LoriAzniveBerberian/PARcast/prototyping/E_dzPAR_schematic.pptx

PARcast: E_d(z, PAR) breadboard wiring

In-water profiler: top-down view on a prototyping breadboard

+

–

a

5

ADS1115

16-bit ADC

10

15

DS3231

Real-time clock

20

25

MS5837

Pressure (0x76)

30

35

Teensy 4.1

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
Built-in
microSD slot

USB on right end

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
ADDR

ALRT

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
19 (SCL0)

18 (SDA0)

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
Apogee SQ-500

PAR sensor (0–40 mV, self-powered)

Serial 1559+: White / Black / Clear (grey)

Wire legend

Red — 3.3 V

Notes

• I2C bus shared by ADS1115, DS3231, MS5837

Black — GND

Yellow — SCL (I2C clock)

• Addresses: 0x48, 0x68, 0x76

• Teensy SDA0 = pin 18, SCL0 = pin 19

White → A0

Black → A1

Clear (grey) → GND (shield)

Blue — SDA (I2C data)

White — SQ-500 signal +

Gray dashed — SQ-500 shield

• SQ-500 differential: reads A0 − A1

• SQ-500 self-powered, no Vcc

• Underwater: apply 1.25× immersion factor

• MS5837 sealed via 1.8×0.8 mm O-ring

## Slide 2

E_d(z, PAR) connection table

Authoritative pin-by-pin reference for build

From | Pin / wire | To | Pin / wire | Wire color | Purpose
Teensy 4.1 | 3V3 | Breadboard | Top + rail | Red | Main 3.3 V distribution
Teensy 4.1 | GND | Breadboard | Top – rail | Black | Main ground distribution
Top + rail | — | ADS1115 | VDD | Red | ADC power
Top – rail | — | ADS1115 | GND | Black | ADC ground
Top + rail | — | DS3231 | Vin | Red | RTC power
Top – rail | — | DS3231 | GND | Black | RTC ground
Top + rail | — | MS5837 | VDD | Red | Pressure sensor power
Top – rail | — | MS5837 | GND | Black | Pressure sensor ground
Teensy 4.1 | Pin 18 (SDA0) | ADS1115 | SDA | Blue | I2C data
Teensy 4.1 | Pin 18 (SDA0) | DS3231 | SDA | Blue | I2C data (shared bus)
Teensy 4.1 | Pin 18 (SDA0) | MS5837 | SDA | Blue | I2C data (shared bus)
Teensy 4.1 | Pin 19 (SCL0) | ADS1115 | SCL | Yellow | I2C clock
Teensy 4.1 | Pin 19 (SCL0) | DS3231 | SCL | Yellow | I2C clock (shared bus)
Teensy 4.1 | Pin 19 (SCL0) | MS5837 | SCL | Yellow | I2C clock (shared bus)
SQ-500 | White wire | ADS1115 | A0 | White | Sensor signal positive
SQ-500 | Black wire | ADS1115 | A1 | Black | Sensor signal negative
SQ-500 | Clear shield | Bottom – rail | — | Gray (dashed) | Shield to ground
