LoriAzniveBerberian/PARcast/prototyping/E_sPAR_schematic.pptx

PARcast: E_s(PAR) breadboard wiring

Land station reference sensor: top-down view on a prototyping breadboard

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
ADS1115

16-bit ADC

DS3231

Real-time clock

Teensy 4.1

Built-in microSD slot

USB
on right end

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
ADDR

ALRT

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
18 (SDA0)

19 (SCL0)

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
Apogee SQ-500

PAR sensor (0–40 mV, self-powered)

Serial 1559+: White / Black / Clear (grey)

White → A0

Black → A1

Wire legend

Black — GND

Notes

Red — 3.3 V

• I2C bus shared by ADS1115 and DS3231

• ADS1115 address 0x48, DS3231 address 0x68

Clear (grey) → GND (shield)

Yellow — SCL (I2C clock)

Blue — SDA (I2C data)

White — SQ-500 signal +

• Teensy SDA0 = pin 18, SCL0 = pin 19

• SQ-500 differential: reads A0 − A1

• SQ-500 is self-powered, no Vcc

Gray dashed — SQ-500 shield

• microSD lives in Teensy built-in slot

PARcast — github.com/LoriAzniveBerberian/PARcast

## Slide 2

E_d(PAR) connection table

Authoritative pin-by-pin reference for build

From | Pin / wire | To | Pin / wire | Wire color | Purpose
Teensy 4.1 | 3V3 | Breadboard | Top + rail | Red | Main 3.3 V distribution
Teensy 4.1 | GND | Breadboard | Top – rail | Black | Main ground distribution
Top + rail | — | ADS1115 | VDD | Red | ADC power
Top – rail | — | ADS1115 | GND | Black | ADC ground
Top + rail | — | DS3231 | Vin | Red | RTC power
Top – rail | — | DS3231 | GND | Black | RTC ground
Teensy 4.1 | Pin 18 (SDA0) | ADS1115 | SDA | Blue | I2C data
Teensy 4.1 | Pin 18 (SDA0) | DS3231 | SDA | Blue | I2C data (shared bus)
Teensy 4.1 | Pin 19 (SCL0) | ADS1115 | SCL | Yellow | I2C clock
Teensy 4.1 | Pin 19 (SCL0) | DS3231 | SCL | Yellow | I2C clock (shared bus)
SQ-500 | White wire | ADS1115 | A0 | White | Sensor signal positive
SQ-500 | Black wire | ADS1115 | A1 | Black | Sensor signal negative
SQ-500 | Clear shield | Bottom – rail | — | Gray (dashed) | Shield to ground
