LoriAzniveBerberian/PARcast/literature/instrument_design/IMG_1776.png

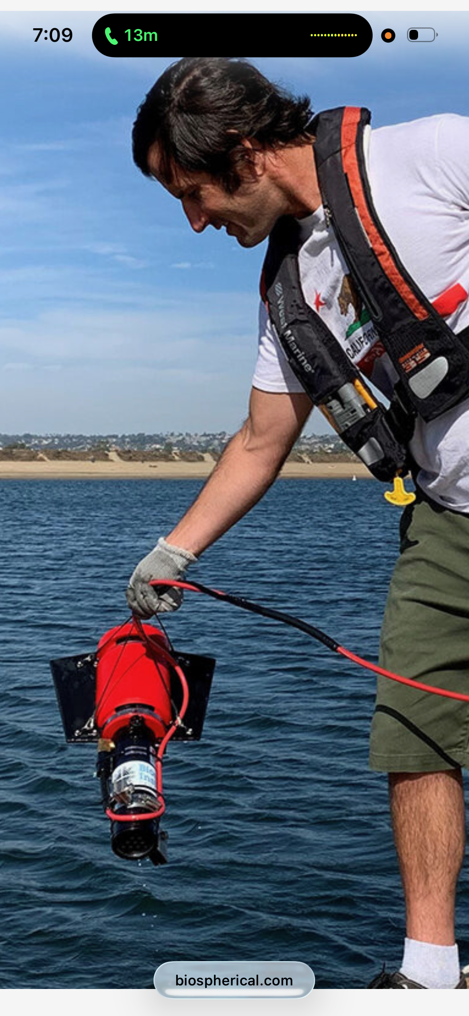
literature/instrument_design/IMG_1776.png
