LoriAzniveBerberian/PARcast/BOM/PARCAST_BOM.xlsx

Sheet: Ed profiler
PARCAST: E_d(z) in-water profiler, Bill of Materials
Item | Part | Qty | Part number | Size (mm) | Purchase link | Unit price (USD) | Line total (USD)
1. Pressure housing
1.1 | Locking tube, cast acrylic, 100 m | 1 | BR-101052-300 | 114.3 OD x 101.6 ID x 300 | https://bluerobotics.com/store/watertight-enclosures/locking-series/wte-locking-tube-r1-vp/ | $230.00 | $230.00
1.2 | O-ring sealing flange, 4 in | 2 | BR-101040 | 114.3 dia x 27 (19.1 inside tube) | https://bluerobotics.com/store/watertight-enclosures/locking-series/wte-flange-vp/ | $50.00 | $100.00
1.3 | End cap, aluminium, 5 x M10, 1000 m | 1 | WTE4-M-END-CAP-5-HOLE | 10 thick; 120.3 dia (CAD) | https://bluerobotics.com/store/watertight-enclosures/locking-series/wte-end-cap-vp/ | $36.00 | $36.00
1.4 | End cap, dome, optically clear polycarbonate, 500 m | 1 |  | 120.3 dia x 12.7 (CAD) | https://bluerobotics.com/store/watertight-enclosures/locking-series/wte-end-cap-vp/ | $42.00 | $42.00
1.5 | Heat shrink sleeve, 120 mm dia | 1 |  | 120 dia (191 flat width) x 1000 |  | $15.09 | $15.09
2. Cap hardware (5 x M10 ports, 56.0 mm bolt circle, 72 deg apart)
2.1 | Pressure relief valve, M10 | 1 | PRV-M10 | M10 thread; 18 dia x 49.5 (CAD) | https://bluerobotics.com/store/watertight-enclosures/enclosure-tools-supplies/prv-m10-asm/ | $32.00 | $32.00
2.2 | Depth / pressure sensor, Bar30, 0-30 bar | 1 | BR-100586 | M10 x 1.5 thread; 16 dia x 32 (CAD) | https://bluerobotics.com/product-category/sensors-cameras/sensors/ | $90.00 | $90.00
2.3 | WetLink penetrator, JPT M10, 4.5 mm HC, 3.7-4.3 mm cable | 3 | BR-107163-145 | M10 bulkhead, 3.7-4.3 cable; 16 A/F x 49 (CAD) | https://bluerobotics.com/store/cables-connectors/penetrators/wetlink-penetrator-jpt/ | $13.00 | $39.00
3. Internal structure
3.1 | Rail, 300 W | 2 | BR-102784-301 | 20 x 7.09 x 231 (CAD) | https://bluerobotics.com/store/watertight-enclosures/locking-series/watertight-enclosure-rails/
3.2 | Rectangular tray, 4 in | 3 | BR-103291-400 | 87 x 68 x 6 (CAD) | https://bluerobotics.com/store/watertight-enclosures/locking-series/watertight-enclosure-rails/ | $24.00 | $72.00
3.3 | Tray accessory mounting screws | 1 |  | M3 x 0.5 | https://bluerobotics.com/product-category/watertight-enclosures/locking-series/ | $3.00 | $3.00
4. Electronics
4.1 | Breadboard, 830-point solderless | 1 | ELEGOO 830-point | 830 tie-points; not listed by vendor |  | $3.00 | $3.00
4.2 | Breadboard, 830-point solderless | 1 | ELEGOO 830-point | 830 tie-points; not listed by vendor |  | $3.00 | $3.00
4.3 | Teensy 4.1 microcontroller | 1 | Adafruit 4622 (PJRC Teensy 4.1) | 61 x 18 (2.4 x 0.7 in) | https://www.adafruit.com/product/4622 | $29.95 | $29.95
4.4 | ADS1115 16-bit I2C ADC module | 1 | Qoroos ADS1115 (3-pack) | not listed by vendor | https://www.amazon.com/dp/B0F1D3KGG2 | $4.29 | $4.29
4.5 | DS3231 precision RTC | 1 | Adafruit 3013 | 23 x 17.6 x 7.2 | https://www.adafruit.com/product/3013 | $17.50 | $17.50
4.6 | LSM6DSOX + LIS3MDL 9-DoF IMU | 1 | Adafruit 4517 | 25.4 x 17.8 x 4.7 (CAD) | https://www.adafruit.com/product/4517 | $19.95 | $19.95
4.7 | Screw terminal, 3-way | 1 |  | 15 x 12 x 10 (CAD placeholder)
4.8 | microSD card, 128 GB, Gigastone | 1 |  | microSD standard, 15 x 11 x 1.0 |  | $24.49 | $24.49
4.9 | CR1220 coin cell (RTC backup) | 1 |  | 12 dia x 2.0
4.10 | Male header strips, female headers, F/F jumper wires | 1 | Adafruit 392, Adafruit 3141, HiLetgo 1x40 | 2.54 pitch; jumpers 150 long | https://www.adafruit.com/product/392 | $13.89 | $13.89
4.11 | USB-C to micro-USB cable, 6 in | 1 |  | 152 length (6 in) | https://www.amazon.com/dp/B0CMLS2MB1 | $12.16 | $12.16
4.12 | V25 USB battery pack | 1 | Voltaic V25 | 80 x 82 x 24 | https://voltaicsystems.com/v25/ | $45.00 | $45.00
4.13 | Hookup wire, 22 AWG solid core (6 colours x 30 ft) | 1 |  | 22 AWG; 6 x 9.1 m (30 ft) |  | $15.89 | $15.89
5. External mounting
5.1 | Enclosure cradle half | 2 | BR-102678-004 | 144.9 x 62.8 x 30 (CAD) | https://bluerobotics.com/store/rov/bluerov2-components-spares/brov2-asm-cradle-set-r1-rp/
5.2 | Tether cleat, aluminium | 2 | custom | 72 x 55 x 6, 13 dia M12 bore (CAD)
5.3 | M12 tether hardware (bolt, nuts, washers) | 1 |  | M12 x 1.75
6. Optical sensor
6.1 | Apogee SQ-500-SS quantum sensor | 1 | SQ-500-SS | 30.5 dia x 36.6 | https://www.apogeeinstruments.com/sq-500-ss-full-spectrum-quantum-sensor/ | $416.12 | $416.12
6.2 | Z-bracket riser | 1 | custom, 3D printed | 58.5 x 30.5 x 44.5 (CAD)
7. Deployment
7.1 | Ballast discs, stainless, 1/4 in | 10 |  | 76.2 dia x 6.35 (3 x 1/4 in) |  | $8.99 | $89.95
7.2 | Trim ballast discs, stainless, 2 mm (5-pack) | 1 |  | 76.2 dia x 2 (3 in) |  | $15.75 | $15.75
7.3 | Trim ballast discs, stainless, 1 mm (5-pack) | 1 |  | 76.2 dia x 1 (3 in) |  | $11.01 | $11.01
7.4 | Trim ballast discs, stainless, 0.5 mm (5-pack) | 1 |  | 76.2 dia x 0.5 (3 in) |  | $8.23 | $8.23
7.5 | Closed-cell foam, Minicell, black | 1 |  | 610 x 305 x 114 (24 x 12 x 4.5 in) |  | $38.85 | $38.85
8. Optional deployment accessories (choose per application; not included in TOTAL)
8.1 | Float line, 100 ft, 550 lb (MIMIRACLE) | 1 |  | 30.5 m (100 ft), 550 lb test |  | $99.99 | $99.99
8.2 | Float line, 50 ft, 550 lb (MIMIRACLE) | 1 |  | 15.2 m (50 ft), 550 lb test |  | $69.99 | $69.99
8.3 | Picasso Hydro Float | 2 |  | not listed by vendor | https://www.spearamerica.com/products/picasso-hydro-float | $58.95 | $117.90
8.4 | SpearPro 316 marine stainless bow shackle | 1 |  | 5/32 in | https://www.spearamerica.com/products/316-marine-stainless-bow-shackle | $5.95 | $5.95
8.5 | SpearPro tuna clip with swivel | 2 |  | not listed by vendor | https://www.spearamerica.com/products/tuna-clip-with-swivel | $5.95 | $11.90
8.6 | SpearPro pigtail swivel, 600 lb | 1 |  | 600 lb rated | https://www.spearamerica.com/products/spearpro-pigtail-swivel-600lb | $4.95 | $4.95
 | TOTAL |  |  |  |  |  | $1428.12
 | Optional accessories (not in TOTAL) |  |  |  |  |  | $310.68

Sheet: Es surface reference
PARCAST: E_s(PAR) surface reference, Bill of Materials
Item | Part | Qty | Part number | Size (mm) | Purchase link | Unit price (USD) | Line total (USD)
1. Enclosure
1.1 | Weatherproof project box, QILIPSU IP67 ABS | 1 |  | 175 x 124 x 99 (6.9 x 4.9 x 3.9 in) |  | $15.99 | $15.99
1.2 | Cable gland, 1/4 in NPT, IP68 nylon | 2 |  | 1/4 in NPT |  | $0.75 | $1.50
2. Optical sensor
2.1 | Apogee SQ-500-SS quantum sensor | 1 | SQ-500-SS | 30.5 dia x 36.6 | https://www.apogeeinstruments.com/sq-500-ss-full-spectrum-quantum-sensor/ | $416.12 | $416.12
2.2 | Apogee AL-100 solar sensor leveling plate | 1 | AL-100 | not listed by vendor | https://www.apogeeinstruments.com/al-100-solar-sensor-leveling-plate/ | $61.79 | $61.79
3. Electronics
3.1 | Breadboard, 830-point solderless | 1 | ELEGOO 830-point | 830 tie-points; not listed by vendor |  | $3.00 | $3.00
3.2 | Teensy 4.1 microcontroller | 1 | Adafruit 4622 (PJRC Teensy 4.1) | 61 x 18 (2.4 x 0.7 in) | https://www.adafruit.com/product/4622 | $29.95 | $29.95
3.3 | ADS1115 16-bit I2C ADC module | 1 | Qoroos ADS1115 (3-pack) | not listed by vendor | https://www.amazon.com/dp/B0F1D3KGG2 | $4.29 | $4.29
3.4 | DS3231 precision RTC | 1 | Adafruit 3013 | 23 x 17.6 x 7.2 | https://www.adafruit.com/product/3013 | $17.50 | $17.50
3.5 | microSD card, 128 GB, Gigastone | 1 |  | microSD standard, 15 x 11 x 1.0 |  | $24.49 | $24.49
3.6 | USB-C to micro-USB cable, 6 in | 1 |  | 152 length (6 in) | https://www.amazon.com/dp/B0CMLS2MB1 | $12.16 | $12.16
4. Power
4.1 | V25 USB battery pack | 1 | Voltaic V25 | 80 x 82 x 24 | https://voltaicsystems.com/v25/ | $45.00 | $45.00
5. Mounting
5.1 | Antenna pole mount bracket, double U-bracket | 1 | MOOKEERF | not listed by vendor |  | $16.99 | $16.99
5.2 | Industrial velcro strips | 1 |  | 102 x 51 (4 x 2 in) |  | $5.47 | $5.47
 | TOTAL |  |  |  |  |  | $654.25
