LoriAzniveBerberian/PARcast/prototyping/E_sPAR_schematic.pdf

# PARcast: E_s(PAR) breadboard wiring

### Land station reference sensor: top-down view on a prototyping breadboard

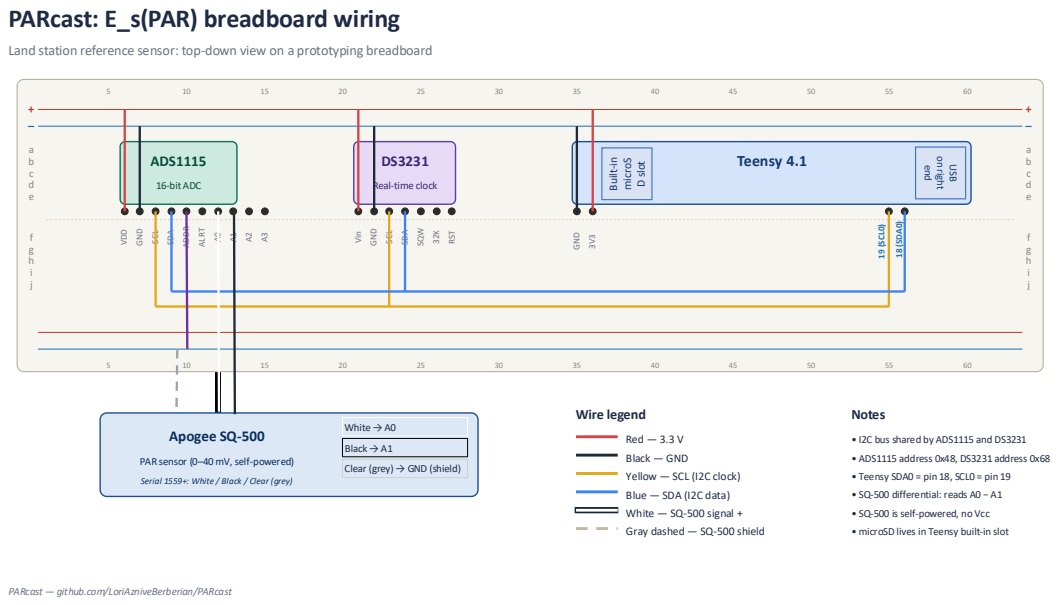
[picture p5: page 1]
ADS1115; 16-bit ADC; VDD; GND; SCL; SDA; ADDR; ALRT; Vin; SQW; RST; Teensy 4.1; 19 (SCL0); 18 (SDA0); Apogee SQ-500; Wire legend; Notes; Built-in; microS; D slot; USB; on right; end

Real-time clock

White → A0
Black → A1
Clear (grey) → GND (shield)

Red — 3.3 V
Black — GND
Yellow — SCL (I2C clock)
Blue — SDA (I2C data)
White — SQ-500 signal +
Gray dashed — SQ-500 shield

• I2C bus shared by ADS1115 and DS3231
• ADS1115 address 0x48, DS3231 address 0x68
• Teensy SDA0 = pin 18, SCL0 = pin 19
• SQ-500 differential: reads A0 − A1
• SQ-500 is self-powered, no Vcc
• microSD lives in Teensy built-in slot

PAR sensor (0–40 mV, self-powered)

Serial 1559+: White / Black / Clear (grey)

PARcast — github.com/LoriAzniveBerberian/PARcast

# E_d(PAR) connection table

### Authoritative pin-by-pin reference for build

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
